EngYork/2023-cny-lamp/poster Square.png

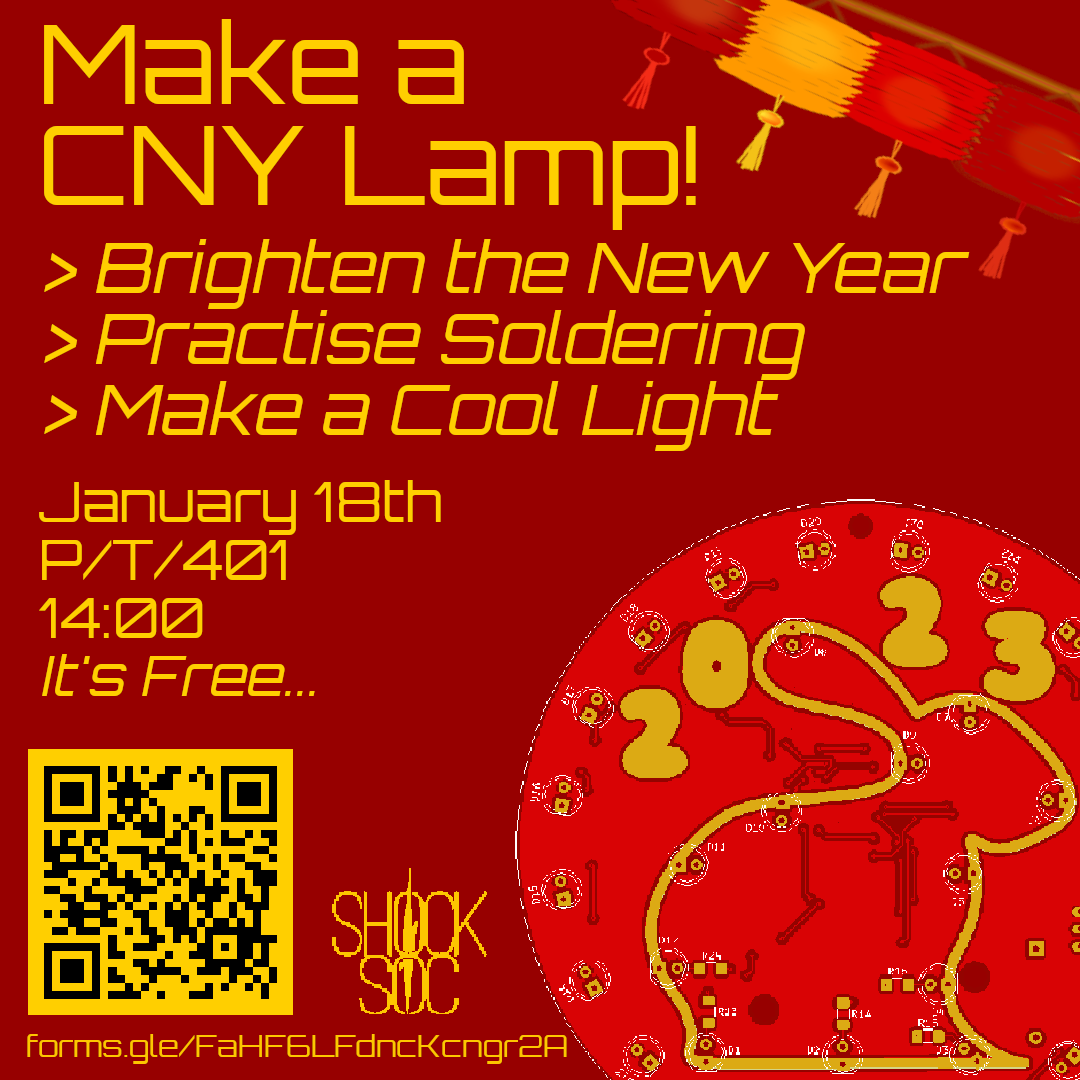
poster Square.png
