EngYork/2023-cny-lamp/poster.png

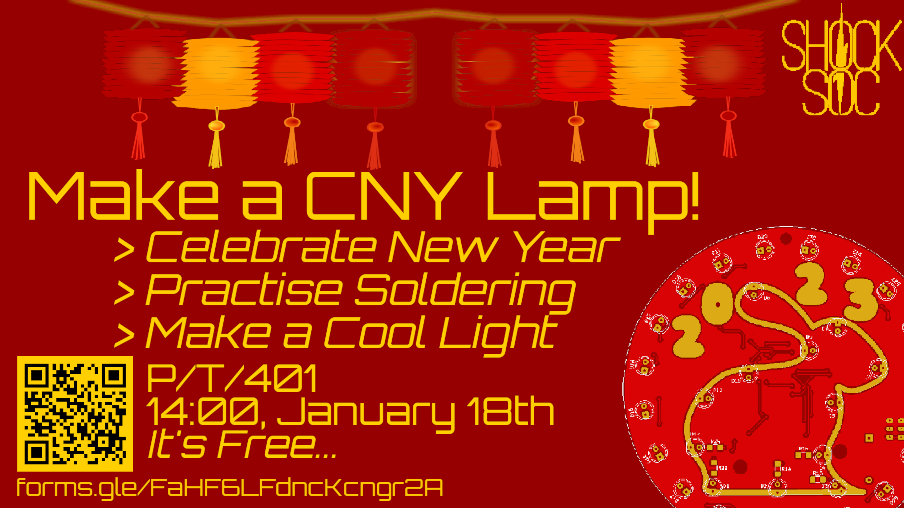
poster.png
