EngYork/2023-cny-lamp/cny lamp.ods

Source: | /home/david/Documents/ShockSoc/cny lamp/cny lamp.kicad_sch |  |  | Spare Comps: | 2 | Boards to Build: | 35
Date: | Sat 07 Jan 2023 15:38:45 GMT |  |  |  |  | Cost/Board: | 8.151
Tool: | Eeschema (6.0.9) |  |  |  |  | Total Cost: | 291.671
Generator: | /usr/share/kicad/plugins/bom_csv_grouped_by_value_with_fp.py
Component Count: | 90
Ref | Qnty | Quantity for All Boards (+Spares) | Value | Cmp name | Footprint | Description | Vendor | Part Number | Price (£) | Total Cost/Board (£) | Sum Cost (£) | Distributor Link
NiMH AAA Cell | 2 | 70 |  | AAA Cell | N/A | AAA Cell | Poundland |  | 0.167 | 0.334 | 11.69
BT1, | 1 | 35 | 2*AAA | Battery Holder | Battery:BatteryHolder_Keystone_2468_2xAAA | Multiple-cell battery | Keystone | 2468 | 0.784 | 0.784 | 27.44 | https://www.mouser.co.uk/ProductDetail/Keystone-Electronics/2468?qs=3CbvriavsLAoISGi3MywrQ%3D%3D
C1, C2, C3, C4, C5, C6, C7, | 7 | 247 | 1u | C | Capacitor_SMD:C_1206_3216Metric_Pad1.33x1.80mm_HandSolder | Unpolarized capacitor | Samsung | CL31B105KBHNFNE | 0.04 | 0.28 | 9.88 | https://www.mouser.co.uk/ProductDetail/Samsung-Electro-Mechanics/CL31B105KBHNFNE
D1, D2, D3, D4, D5, D6, D7, D8, D9, D10, D11, D12, | 12 | 422 | Yellow/Orange/W.White | LED | LED_THT:LED_D5.0mm | Light emitting diode | Kingbright | WP1503YC | 0.101 | 1.212 | 42.622 | https://www.mouser.co.uk/ProductDetail/Kingbright/WP1503YC?qs=sGAEpiMZZMvHYEB9WUp7Eo9I4xS6qgPtlqd1jfqBVJ8%3D
D13, D14, D15, D16, D17, D18, D19, D20, D21, D22, D23, D24, D25, D26, D27, D28, D29, D30, D31, D32, | 20 | 702 | Red | LED | LED_THT:LED_D5.0mm | Light emitting diode | Kingbright | WP1503EC | 0.09 | 1.8 | 63.18 | https://www.mouser.co.uk/ProductDetail/Kingbright/WP1503EC?qs=sGAEpiMZZMvHYEB9WUp7Eo9I4xS6qgPtONGLmsvopH4%3D
Q1, Q2, | 2 | 72 | DMN63D8LW-7 | DMN63D8LW-7 | Package_TO_SOT_SMD:SOT-323_SC-70_Handsoldering | N-Channel MOSFET, SOT-323 | Diodes Inc | DMN63D8LW-7 | 0.095 | 0.19 | 6.84 | https://www.mouser.co.uk/ProductDetail/Diodes-Incorporated/DMN63D8LW-7?qs=nQSIdc08i%252BdeaOzEDVtdYQ%3D%3D
R1, R2, R3, R5, R6, R8, R10, | 7 | 247 | 100k | R | Resistor_SMD:R_1206_3216Metric_Pad1.30x1.75mm_HandSolder | Resistor | Bourns | CR1206-FX-1003ELF | 0.017 | 0.119 | 4.199 | https://www.mouser.co.uk/ProductDetail/Bourns/CR1206-FX-1003ELF
R4, R13, R14, R15, R16, R17, R18, R19, R20, R21, R22, R23, R24, R25, R26, R27, R28, R29, R30, R31, R32, R33, R34, R35, R36, R37, R38, R39, R40, R41, R42, R43, R44, | 33 | 1157 | 82 | R | Resistor_SMD:R_1206_3216Metric_Pad1.30x1.75mm_HandSolder | Resistor | Bourns | CR1206-FX-82R0ELF | 0.008 | 0.264 | 9.256 | https://www.mouser.co.uk/ProductDetail/Bourns/CR1206-FX-82R0ELF
R7, | 1 | 37 | 390k | R | Resistor_SMD:R_1206_3216Metric_Pad1.30x1.75mm_HandSolder | Resistor | Bourns | CR1206-FX-3903ELF | 0.04 | 0.04 | 1.48 | https://www.mouser.co.uk/ProductDetail/Bourns/CR1206-FX-3903ELF
R9, | 1 | 37 | 220k | R | Resistor_SMD:R_1206_3216Metric_Pad1.30x1.75mm_HandSolder | Resistor | Bourns | CR1206-JW-224ELF | 0.037 | 0.037 | 1.369 | https://www.mouser.co.uk/ProductDetail/Bourns/CR1206-JW-224ELF
R11, | 1 | 37 | 2.7M | R | Resistor_SMD:R_1206_3216Metric_Pad1.30x1.75mm_HandSolder | Resistor | Bourns | CR1206-JW-275ELF | 0.037 | 0.037 | 1.369 | https://www.mouser.co.uk/ProductDetail/Bourns/CR1206-JW-275ELF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
R12, | 1 | 37 | 1.5M | R | Resistor_SMD:R_1206_3216Metric_Pad1.30x1.75mm_HandSolder | Resistor | Bourns | CR1206-JW-155ELF | 0.037 | 0.037 | 1.369 | https://www.mouser.co.uk/ProductDetail/Bourns/CR1206-JW-155ELF
SW1, | 1 | 37 | MHSS1104 | SW_SPDT | Library:MHSS1104 | Switch, single pole double throw | APEM | MHSS1104 | 0.54 | 0.54 | 19.98 | https://www.mouser.co.uk/ProductDetail/Apem/MHSS1104?qs=pNV45xh2Ia0Qd2iCcgHqxg%3D%3D
U1, | 1 | 37 | TC75W56 | TC75W56FK | Package_SO:VSSOP-8_2.3x2mm_P0.5mm | Low-Power, Low-Offset Voltage, Dual Comparators, DIP-8/SOIC-8/SOP-8/TSSOP-8/VSSOP-8 | Toshiba | TC75W56FK | 0.345 | 0.345 | 12.765 | https://www.mouser.co.uk/ProductDetail/Toshiba/TC75W56FKLF?qs=lX6dEUlT%252Bgcxje8Q1nYZWw%3D%3D
U2, U3, | 2 | 72 | 74HC164 | 74HC164 | Package_SO:SOIC-14_3.9x8.7mm_P1.27mm | 8-bit serial-in parallel-out shift register | Onsemi | MC74HC164ADR2G | 0.326 | 0.652 | 23.472 | https://www.mouser.co.uk/ProductDetail/onsemi/MC74HC164ADR2G
PCB | 1 | 37 |  | PCB | N/A | Board | JLC |  | 1.48 | 1.48 | 54.76 | Purchased
