EngYork/2023-cny-lamp/schematic.pdf

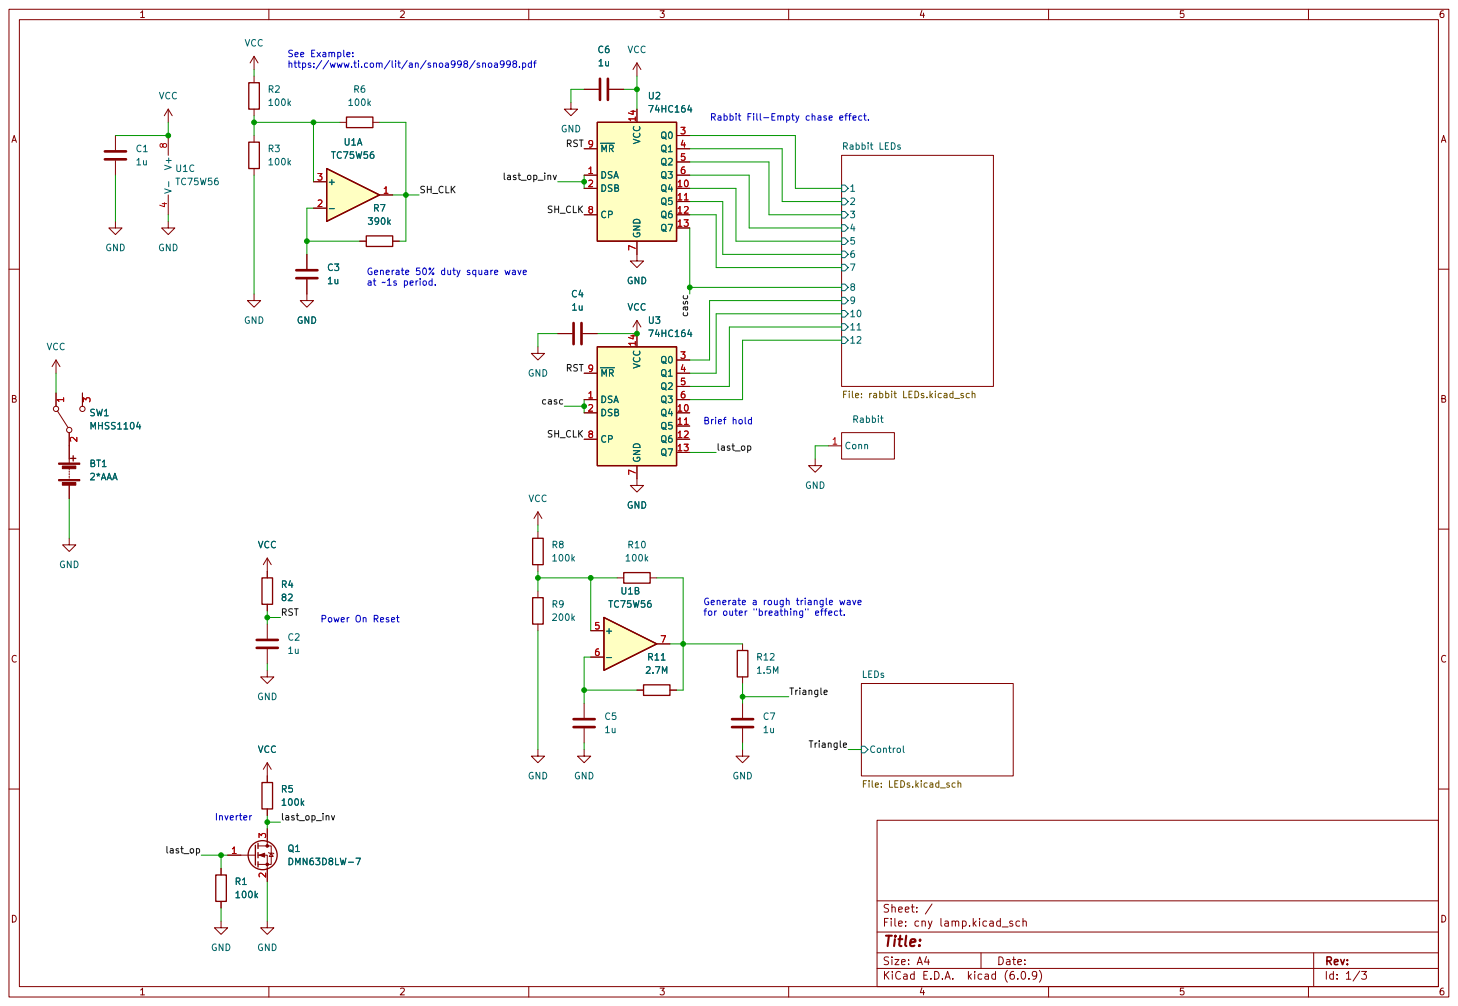
[picture p3: page 1]

https://www.ti.com/lit/an/snoa998/snoa998.pdf Power On Reset VCC
74HC164 GND

GND
File: cny lamp.kicad_sch Sheet: / 89

Rabbit Fill-Empty chase effect.

Generate 50% duty square wave
at ~1s period.

Generate a rough triangle wave
for outer "breathing" effect.

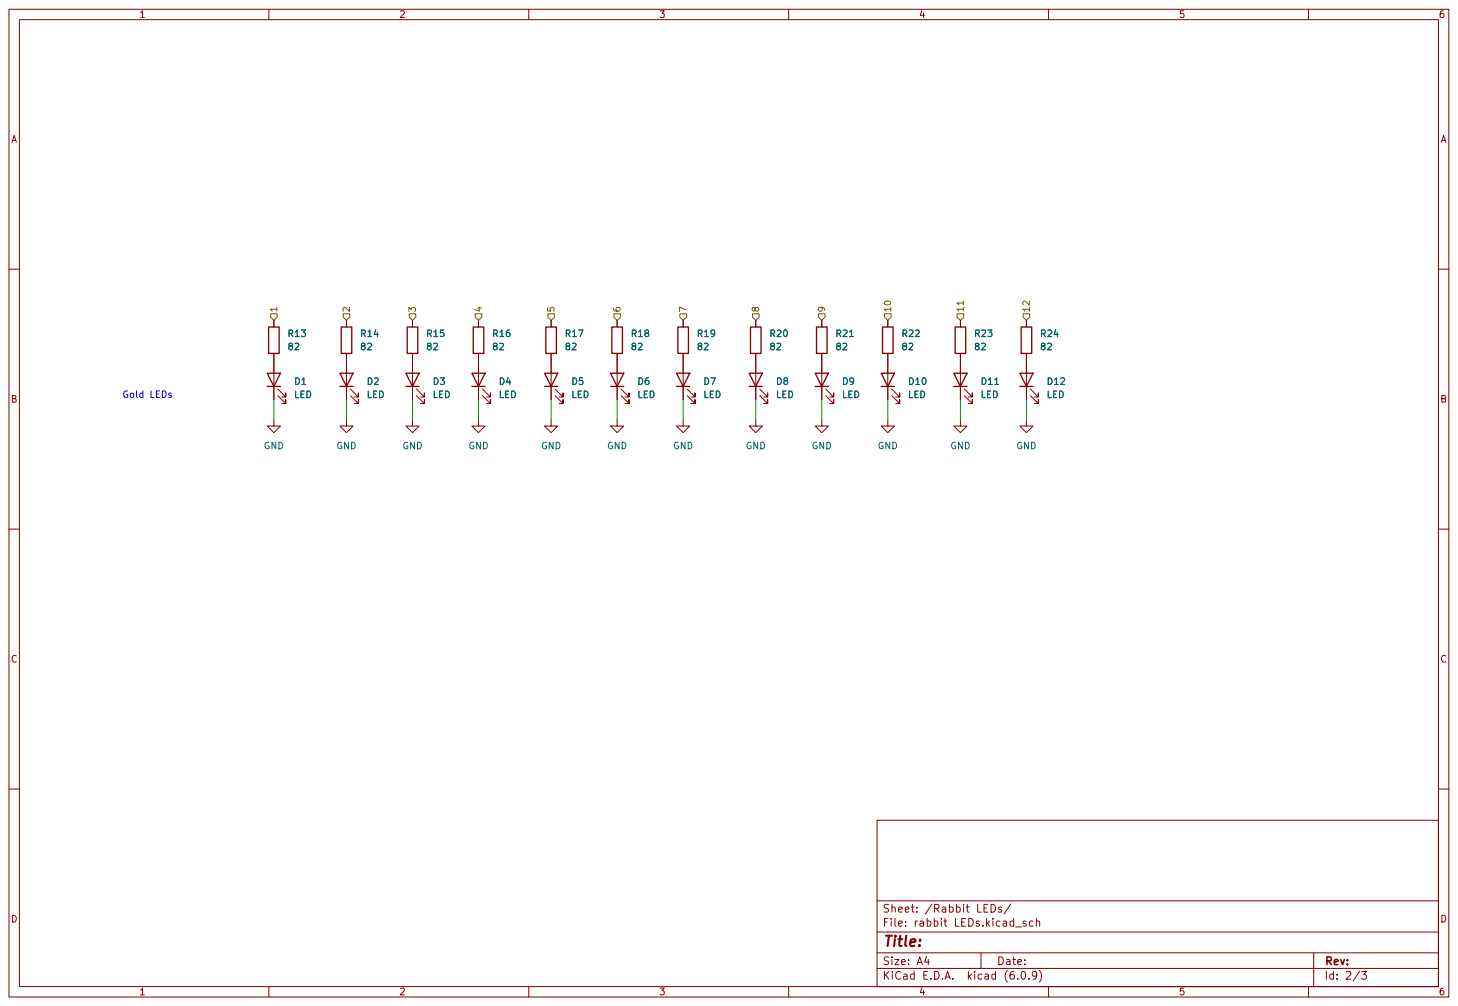
[picture p4: page 2]

File: rabbit LEDs.kicad_sch Sheet: /Rabbit LEDs/
Id: 2/3 Title:

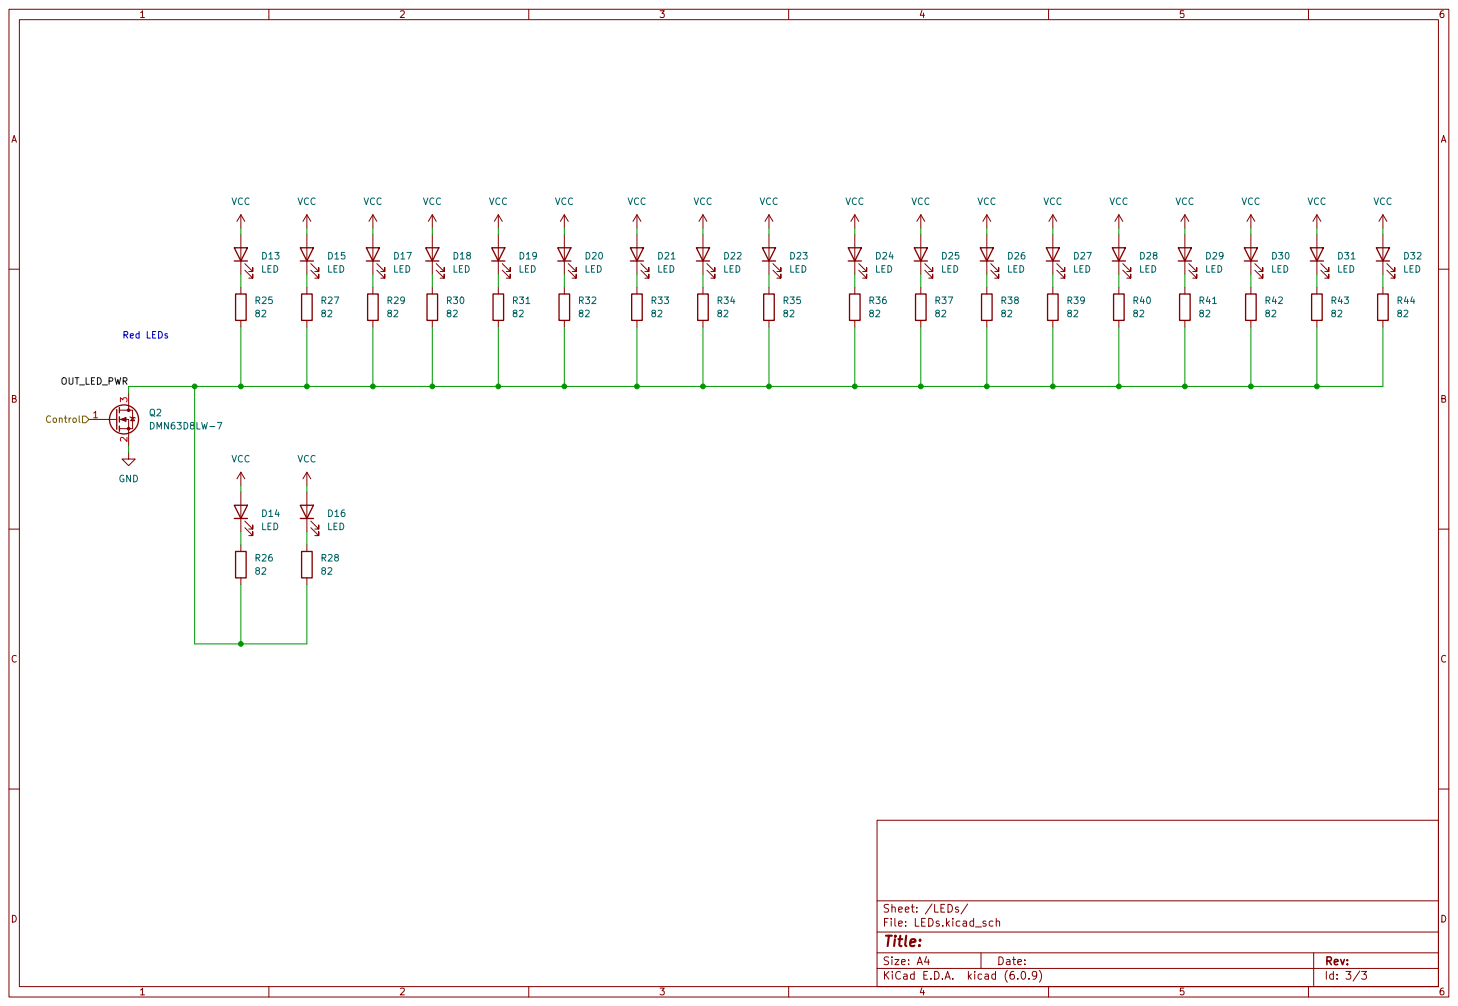
[picture p5: page 3]

File: LEDs.kicad_sch Sheet: /LEDs/
Id: 3/3 Title:
