EngYork/2023-cny-lamp/cny lamp.kicad_pcb

## KiCad design cny lamp.kicad_pcb (2022-12-31)

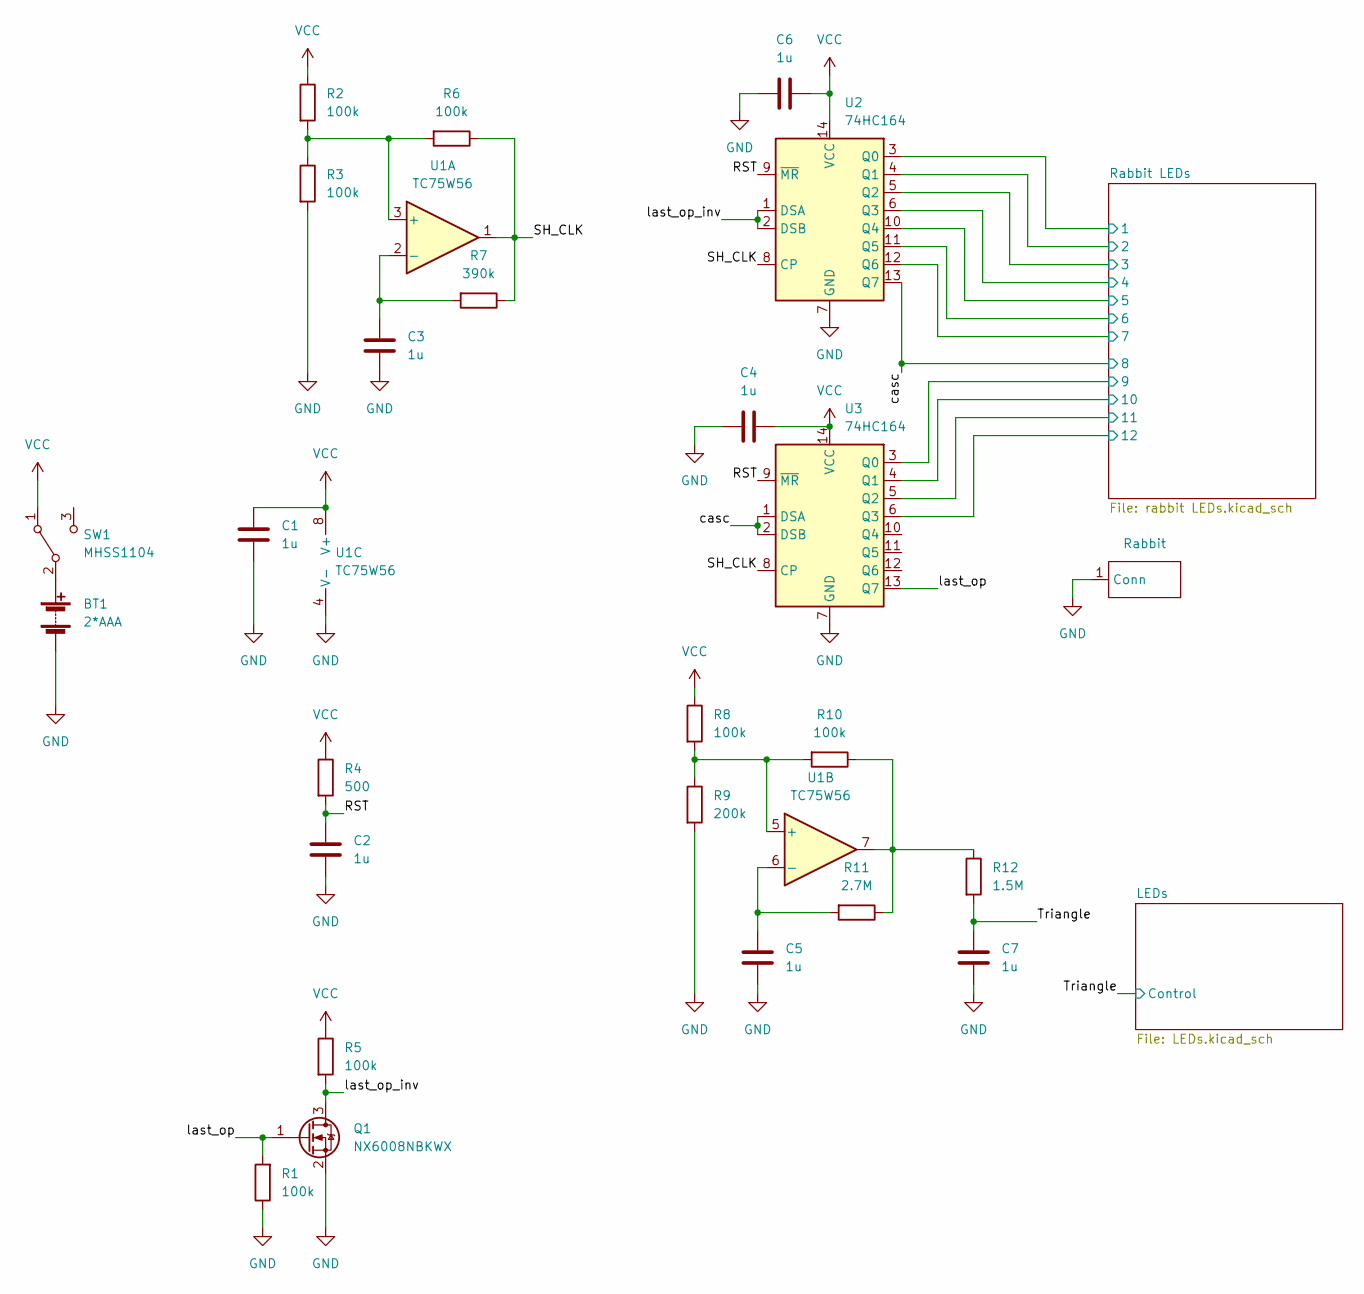
[picture p6: schematic cny lamp.kicad_sch]

Parts:
BT1: 2*AAA; BatteryHolder_Keystone_2468_2xAAA
C1, C2, C3, C4, C5, C6, C7: 1u; C_1206_3216Metric_Pad1.33x1.80mm_HandSolder
Q1: NX6008NBKWX; SOT-323_SC-70_Handsoldering
R1, R2, R3, R5, R6, R8, R10: 100k; R_1206_3216Metric_Pad1.30x1.75mm_HandSolder
R4: 500; R_1206_3216Metric_Pad1.30x1.75mm_HandSolder
R7: 390k; R_1206_3216Metric_Pad1.30x1.75mm_HandSolder
R9: 200k; R_1206_3216Metric_Pad1.30x1.75mm_HandSolder
R11: 2.7M; R_1206_3216Metric_Pad1.30x1.75mm_HandSolder
R12: 1.5M; R_1206_3216Metric_Pad1.30x1.75mm_HandSolder
SW1: MHSS1104
U1: TC75W56; VSSOP-8_2.3x2mm_P0.5mm
U2, U3: 74HC164; SOIC-14_3.9x8.7mm_P1.27mm
U4: Rabbit

Connections:
/RST: C2.1, R4.2, U2.9 (~MR), U3.9 (~MR)
/Rabbit LEDs/1: U2.3 (Q0); also elsewhere on the board
/Rabbit LEDs/2: U2.4 (Q1); also elsewhere on the board
/Rabbit LEDs/3: U2.5 (Q2); also elsewhere on the board
/Rabbit LEDs/4: U2.6 (Q3); also elsewhere on the board
/Rabbit LEDs/5: U2.10 (Q4); also elsewhere on the board
/Rabbit LEDs/6: U2.11 (Q5); also elsewhere on the board
/Rabbit LEDs/7: U2.12 (Q6); also elsewhere on the board
/Rabbit LEDs/9: U3.3 (Q0); also elsewhere on the board
/Rabbit LEDs/10: U3.4 (Q1); also elsewhere on the board
/Rabbit LEDs/11: U3.5 (Q2); also elsewhere on the board
/Rabbit LEDs/12: U3.6 (Q3); also elsewhere on the board
/SH_CLK: R6.1, R7.1, U1.1, U2.8 (CP), U3.8 (CP)
/Triangle: C7.1, R12.2; also elsewhere on the board
/casc: U2.13 (Q7), U3.1 (DSA), U3.2 (DSB); also elsewhere on the board
/last_op: Q1.1 (G), R1.2, U3.13 (Q7)
/last_op_inv: Q1.3 (D), R5.2, U2.1 (DSA), U2.2 (DSB)
GND: BT1.2 (-), C1.2, C2.2, C3.2, C4.1, C5.2, C6.1, C7.2, Q1.2 (S), R1.1, R3.2, R9.2, U1.4 (V-), U2.7 (GND), U3.7 (GND), U4.1 (Conn); also elsewhere on the board
unnamed: BT1.1 (+), SW1.2 (B)
unnamed: C3.1, R7.2, U1.2 (-)
unnamed: C5.1, R11.2, U1.6 (-)
unnamed: R2.2, R3.1, R6.2, U1.3 (+)
unnamed: R10.1, R11.1, R12.1, U1.7
unnamed: R8.2, R9.1, R10.2, U1.5 (+)
VCC: C1.1, C4.2, C6.2, R2.1, R4.1, R5.1, R8.1, SW1.1 (A), U1.8 (V+), U2.14 (VCC), U3.14 (VCC); also elsewhere on the board

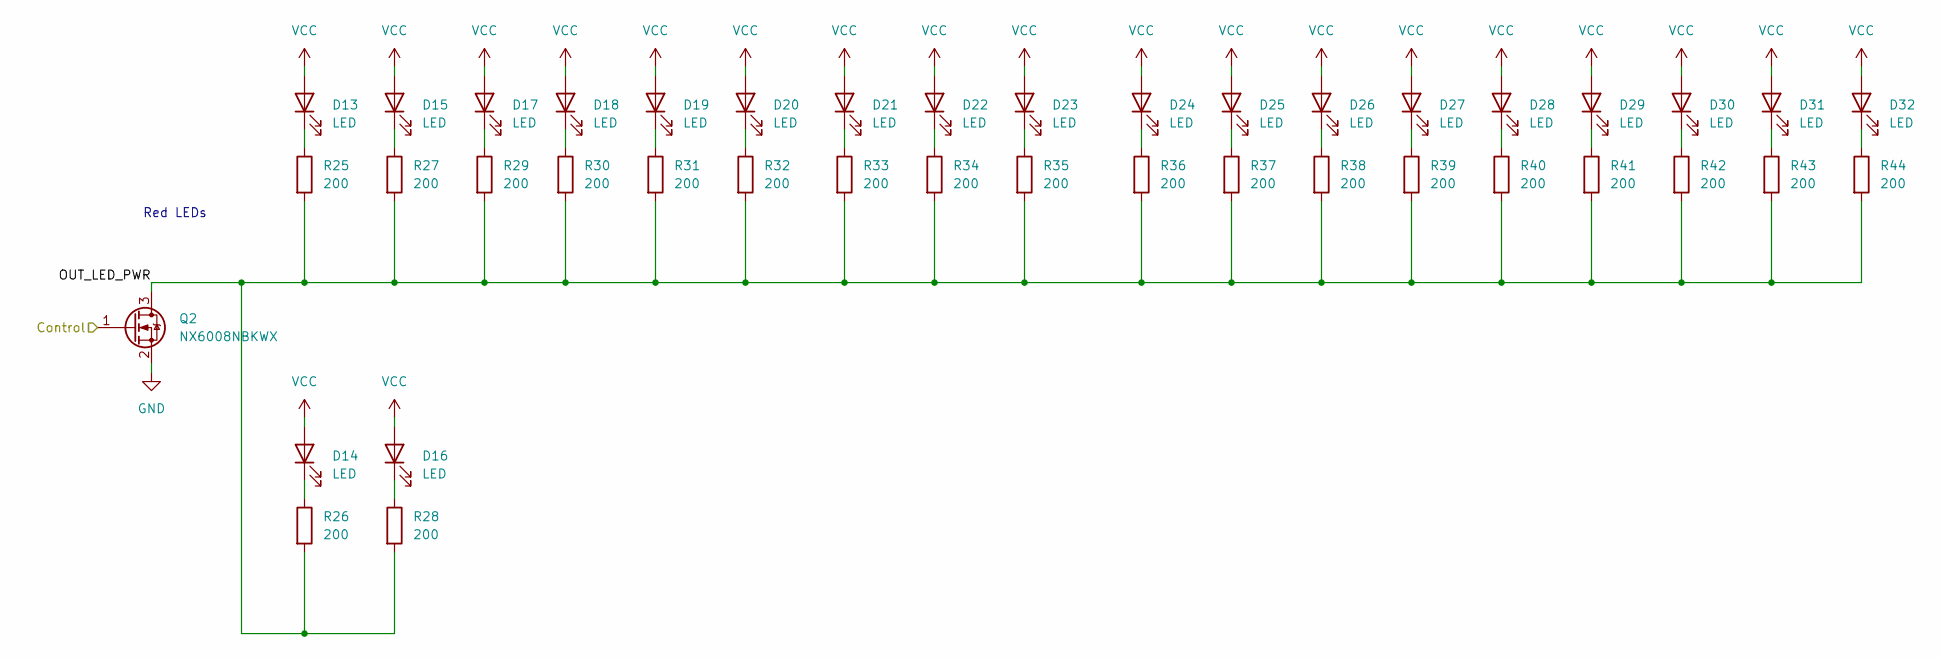
[picture p7: schematic LEDs.kicad_sch]

Parts:
D13, D14, D15, D16, D17, D18, D19, D20, D21, D22, D23, D24, D25, D26, D27, D28, D29, D30, D31, D32: LED; LED_D5.0mm
Q2: NX6008NBKWX; SOT-323_SC-70_Handsoldering
R25, R26, R27, R28, R29, R30, R31, R32, R33, R34, R35, R36, R37, R38, R39, R40, R41, R42, R43, R44: 200; R_1206_3216Metric_Pad1.30x1.75mm_HandSolder

Connections:
/LEDs/OUT_LED_PWR: Q2.3 (D), R25.2, R26.2, R27.2, R28.2, R29.2, R30.2, R31.2, R32.2, R33.2, R34.2, R35.2, R36.2, R37.2, R38.2, R39.2, R40.2, R41.2, R42.2, R43.2, R44.2
/Triangle: Q2.1 (G); also elsewhere on the board
GND: Q2.2 (S); also elsewhere on the board
unnamed: D13.1 (K), R25.1
unnamed: D14.1 (K), R26.1
unnamed: D15.1 (K), R27.1
unnamed: D16.1 (K), R28.1
unnamed: D17.1 (K), R29.1
unnamed: D18.1 (K), R30.1
unnamed: D19.1 (K), R31.1
unnamed: D20.1 (K), R32.1
unnamed: D21.1 (K), R33.1
unnamed: D22.1 (K), R34.1
unnamed: D23.1 (K), R35.1
unnamed: D24.1 (K), R36.1
unnamed: D25.1 (K), R37.1
unnamed: D26.1 (K), R38.1
unnamed: D27.1 (K), R39.1
unnamed: D28.1 (K), R40.1
unnamed: D29.1 (K), R41.1
unnamed: D30.1 (K), R42.1
unnamed: D31.1 (K), R43.1
unnamed: D32.1 (K), R44.1
VCC: D13.2 (A), D14.2 (A), D15.2 (A), D16.2 (A), D17.2 (A), D18.2 (A), D19.2 (A), D20.2 (A), D21.2 (A), D22.2 (A), D23.2 (A), D24.2 (A), D25.2 (A), D26.2 (A), D27.2 (A), D28.2 (A), D29.2 (A), D30.2 (A), D31.2 (A), D32.2 (A); also elsewhere on the board

Notes on the sheet:
Red LEDs

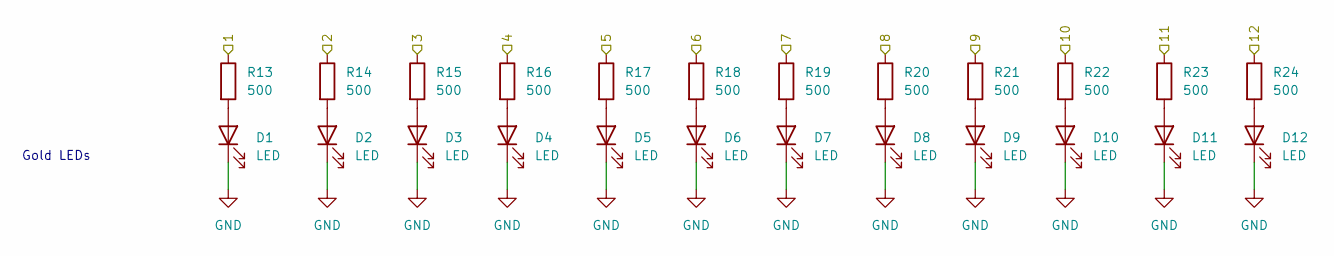
[picture p8: schematic rabbit LEDs.kicad_sch]

Parts:
D1, D2, D3, D4, D5, D6, D7, D8, D9, D10, D11, D12: LED; LED_D5.0mm
R13, R14, R15, R16, R17, R18, R19, R20, R21, R22, R23, R24: 500; R_1206_3216Metric_Pad1.30x1.75mm_HandSolder

Connections:
/Rabbit LEDs/1: R13.1; also elsewhere on the board
/Rabbit LEDs/2: R14.1; also elsewhere on the board
/Rabbit LEDs/3: R15.1; also elsewhere on the board
/Rabbit LEDs/4: R16.1; also elsewhere on the board
/Rabbit LEDs/5: R17.1; also elsewhere on the board
/Rabbit LEDs/6: R18.1; also elsewhere on the board
/Rabbit LEDs/7: R19.1; also elsewhere on the board
/Rabbit LEDs/9: R21.1; also elsewhere on the board
/Rabbit LEDs/10: R22.1; also elsewhere on the board
/Rabbit LEDs/11: R23.1; also elsewhere on the board
/Rabbit LEDs/12: R24.1; also elsewhere on the board
/casc: R20.1; also elsewhere on the board
GND: D1.1 (K), D2.1 (K), D3.1 (K), D4.1 (K), D5.1 (K), D6.1 (K), D7.1 (K), D8.1 (K), D9.1 (K), D10.1 (K), D11.1 (K), D12.1 (K); also elsewhere on the board
unnamed: D1.2 (A), R13.2
unnamed: D2.2 (A), R14.2
unnamed: D3.2 (A), R15.2
unnamed: D4.2 (A), R16.2
unnamed: D5.2 (A), R17.2
unnamed: D6.2 (A), R18.2
unnamed: D7.2 (A), R19.2
unnamed: D8.2 (A), R20.2
unnamed: D9.2 (A), R21.2
unnamed: D10.2 (A), R22.2
unnamed: D11.2 (A), R23.2
unnamed: D12.2 (A), R24.2

Notes on the sheet:
Gold LEDs

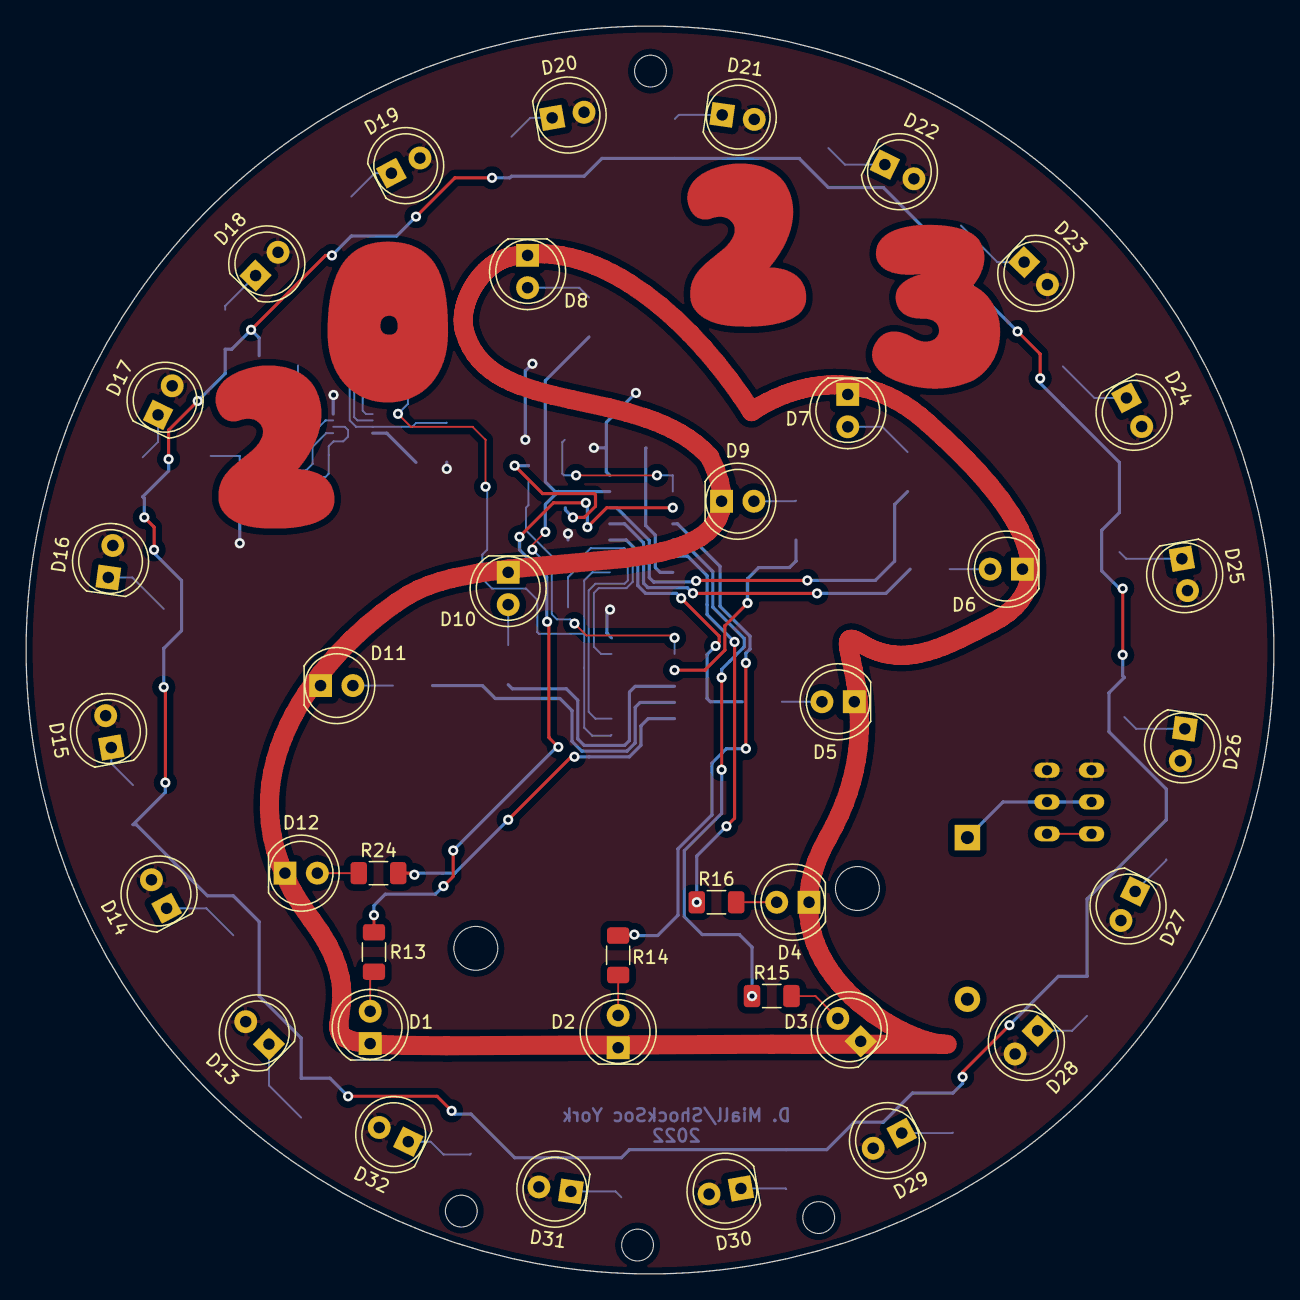
[picture p9: board cny lamp.kicad_pcb from above]

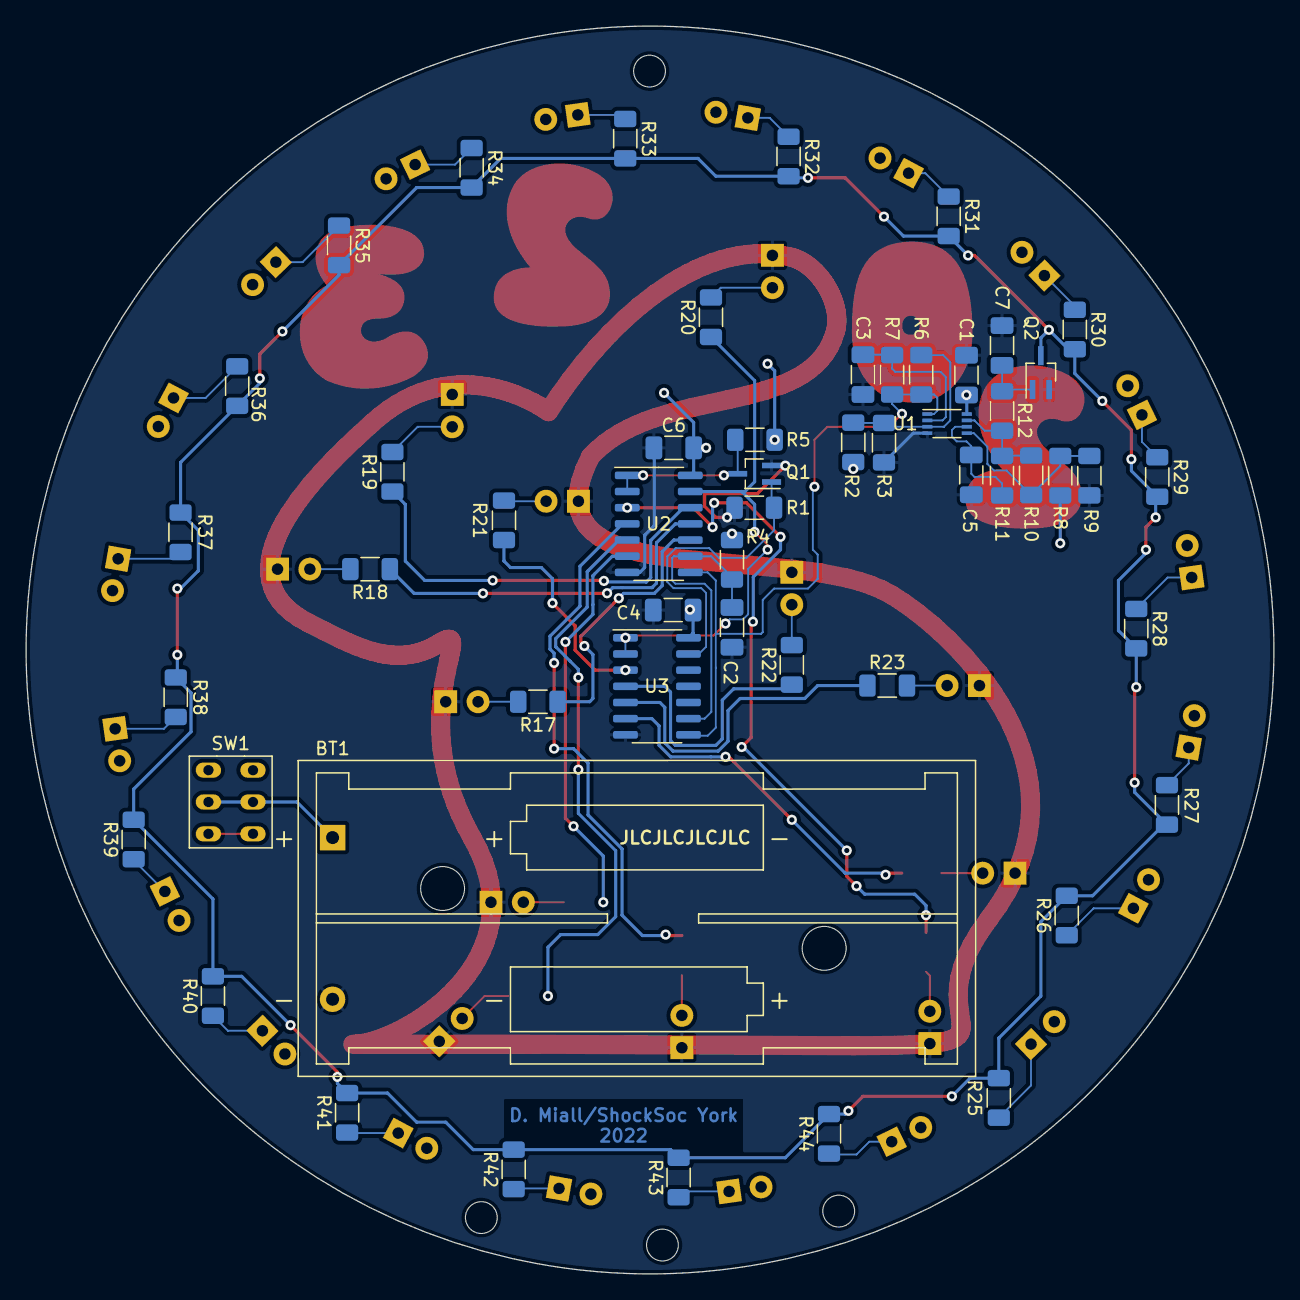
[picture p10: board cny lamp.kicad_pcb from below]

Board: 2 copper layers, 98.0 x 98.0 mm, 91 parts (53 on the bottom side), 58 nets.
