EngYork/2023-cny-lamp/(commit log)

2022-12-31 Init repo
    [LEDs.kicad_sch, cny lamp.kicad_pcb, cny lamp.kicad_sch, rabbit LEDs.kicad_sch]
2022-12-31 Remove schematic -bak
2022-12-31 Label schematic
    [cny lamp.kicad_sch]
2023-01-07 Add BoM and complete board
    [LEDs.kicad_sch, cny lamp.csv, cny lamp.kicad_sch, rabbit LEDs.kicad_sch]
2023-01-07 Add ODS BoM
    [cny lamp.ods]
2023-01-17 Schematic PDF
    [cny lamp.csv, cny lamp.ods]
